jorgebrito777/ArduinoMatlabBola-Plato/coneccion.PNG

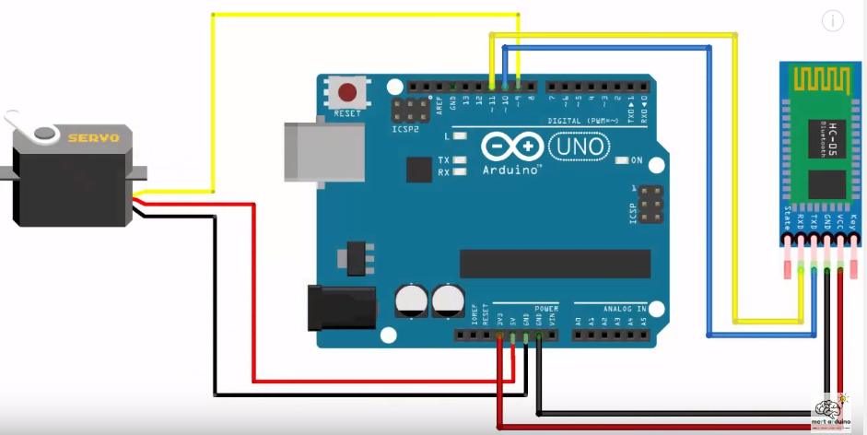
coneccion.PNG
