jorgebrito777/ArduinoMatlabBola-Plato/_2servos_arduino_android/_2servos_arduino_android.ino

#include <SoftwareSerial.h> // TX RX software library for bluetooth

#include <Servo.h> // servo library 
Servo myservo1, myservo2, myservo3, myservo4; // servo name

int bluetoothTx = 10; // bluetooth tx to 10 pin
int bluetoothRx = 11; // bluetooth rx to 11 pin

SoftwareSerial bluetooth(bluetoothTx, bluetoothRx);

void setup()
{
  myservo1.attach(3); // attach servo signal wire to pin 9
  myservo2.attach(5);
  
  //Setup usb serial connection to computer
  Serial.begin(9600);

  //Setup Bluetooth serial connection to android
  bluetooth.begin(9600);
}

void loop()
{
  //Read from bluetooth and write to usb serial
  if(bluetooth.available()>= 2 )
  {
    unsigned int servopos = bluetooth.read();
    unsigned int servopos1 = bluetooth.read();
    unsigned int realservo = (servopos1 *256) + servopos;
    Serial.println(realservo);

    if (realservo >= 1000 && realservo <1180) {
      int servo1 = realservo;
      servo1 = map(servo1, 1000, 1180, 0, 180);
      myservo1.write(servo1);
      Serial.println("Servo 1 ON");
      delay(10);
    }
    if (realservo >= 2000 && realservo <2180) {
      int servo2 = realservo;
      servo2 = map(servo2, 2000, 2180, 0, 180);
      myservo2.write(servo2);
      Serial.println("Servo 2 ON");
      delay(10);
    }
    
  }
}
