jorgebrito777/ArduinoMatlabBola-Plato/ARDUINOprogramacion/Ultrasonic-HC-SR04-master/Ultrasonic-HC-SR04-master/Ultrasonic/examples/TwoOrMore/TwoOrMore.ino

// Ultrasonic - Library for HR-SC04 Ultrasonic Ranging Module.
// Rev.4 (06/2012)
// J.Rodrigo ( www.jrodrigo.net )
// more info at www.ardublog.com

#include <Ultrasonic.h>

Ultrasonic ultraleft(9,8);   // (Trig PIN,Echo PIN)
Ultrasonic ultraright(6,7);  // (Trig PIN,Echo PIN)

void setup() {
  Serial.begin(9600); 
}

void loop()
{
  Serial.print("Left: ");
  Serial.print(ultraleft.Ranging(CM)); // CM or INC
  Serial.print(" cm     " );
  delay(50);
  Serial.print("Right: ");
  Serial.print(ultraright.Ranging(CM)); // CM or INC
  Serial.println(" cm" );
  delay(50);
}
